marcocancarini/ExpressCardtoNVME/out/EC2M2_34/jlcpcb/EC2M2_34_estimate.md

# EC2M2_34 — JLCPCB estimate

Board size: 34.1 x 70.1 mm, 2 layers, 1.0 mm thick.
Fitted by hand (DNP for JLC): J1, JP1

| LCSC | Part | Qty/board | Type | Stock | Cost for 5 boards | Cost for 10 boards |
|---|---|---|---|---|---|---|
| C45783 | CL21A226MAQNNNE (22uF) | 1 | basic | 3512273 | $1.73 | $2.69 |
| C1525 | CL05B104KO5NNNC (100nF) | 1 | basic | 36039359 | $0.06 | $0.06 |
| C2286 | KT-0603R (LED red) | 1 | basic | 7299726 | $0.15 | $0.15 |
| C5360192 | 9774010243R (M2 SMT nut H1.0) | 2 | extended | 883 | $5.85 | $11.70 |
| C52766481 | MLD-NGFF-M-3.2H (M.2 M-key H3.2) | 1 | extended | 258 | $2.23 | $3.52 |
| C25117 | 0402WGF4700TCE (470) | 1 | basic | 1114424 | $0.03 | $0.03 |

| Components total | 5 boards: $10.05 | 10 boards: $18.16 |
|---|---|---|

Extended parts: 2 (JLC charges a setup fee for each extended part, typically $3 each).
Not included: PCB, assembly setup, stencil, shipping: the quote on the website computes them.
