marcocancarini/ExpressCardtoNVME/out/EC2M2_34_USB5V/jlcpcb/EC2M2_34_USB5V_estimate.md

# EC2M2_34_USB5V — JLCPCB estimate

Board size: 34.1 x 70.1 mm, 2 layers, 1.0 mm thick.
Fitted by hand (DNP for JLC): J1, J3, J4, JP1

| LCSC | Part | Qty/board | Type | Stock | Cost for 5 boards | Cost for 10 boards |
|---|---|---|---|---|---|---|
| C45783 | CL21A226MAQNNNE (22uF) | 1 | basic | 3512376 | $1.73 | $2.69 |
| C1525 | CL05B104KO5NNNC (100nF) | 1 | basic | 36039235 | $0.06 | $0.06 |
| C19702 | CL10A106KP8NNNC (10uF) | 2 | basic | 11884151 | $0.42 | $0.64 |
| C2286 | KT-0603R (LED red) | 1 | basic | 7297232 | $0.15 | $0.15 |
| C5360192 | 9774010243R (M2 SMT nut H1.0) | 2 | extended | 883 | $5.85 | $11.70 |
| C52766481 | MLD-NGFF-M-3.2H (M.2 M-key H3.2) | 1 | extended | 258 | $2.23 | $3.52 |
| C76793 | MLP2016S1R0MT0S1 (1uH) | 1 | extended | 2077 | $0.78 | $1.22 |
| C25117 | 0402WGF4700TCE (470) | 1 | basic | 1114404 | $0.03 | $0.03 |
| C59567 | TPS61240DRVR (TPS61240DRV) | 1 | extended | 2994 | $5.52 | $9.13 |

| Components total | 5 boards: $16.78 | 10 boards: $29.14 |
|---|---|---|

Extended parts: 4 (JLC charges a setup fee for each extended part, typically $3 each).
Not included: PCB, assembly setup, stencil, shipping: the quote on the website computes them.
