marcocancarini/ExpressCardtoNVME/docs/img/EC2M2_34_3d.png

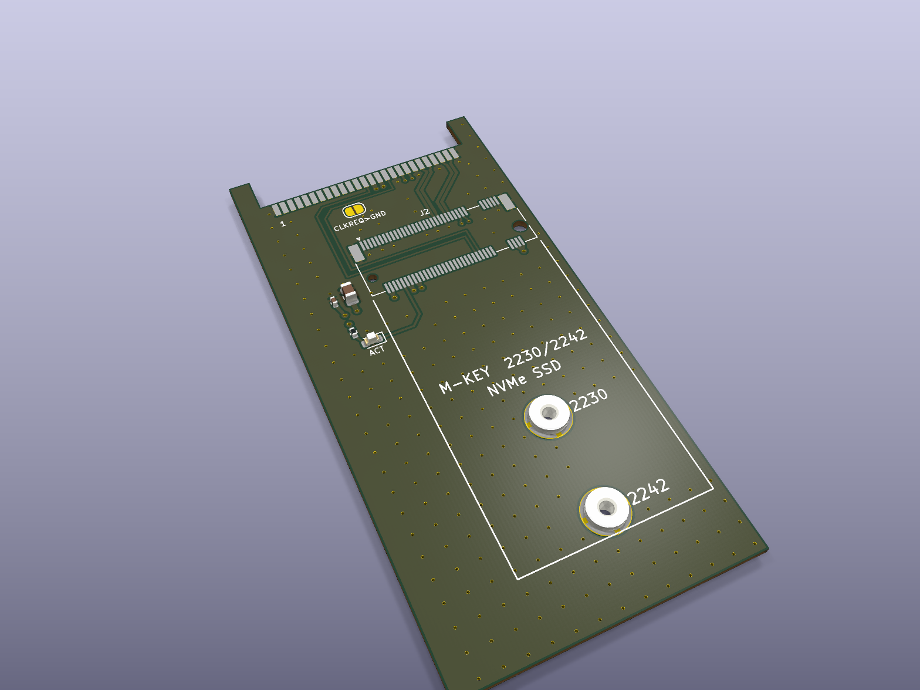
docs/img/EC2M2_34_3d.png
