marcocancarini/ExpressCardtoNVME/docs/img/EC2M2_34_bottom.png

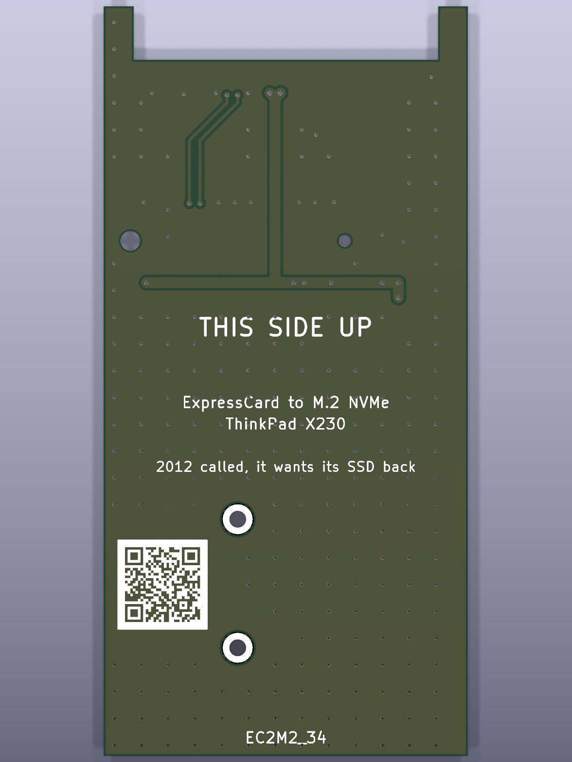
docs/img/EC2M2_34_bottom.png
