marcocancarini/ExpressCardtoNVME/docs/img/EC2M2_34_USB5V_3d.png

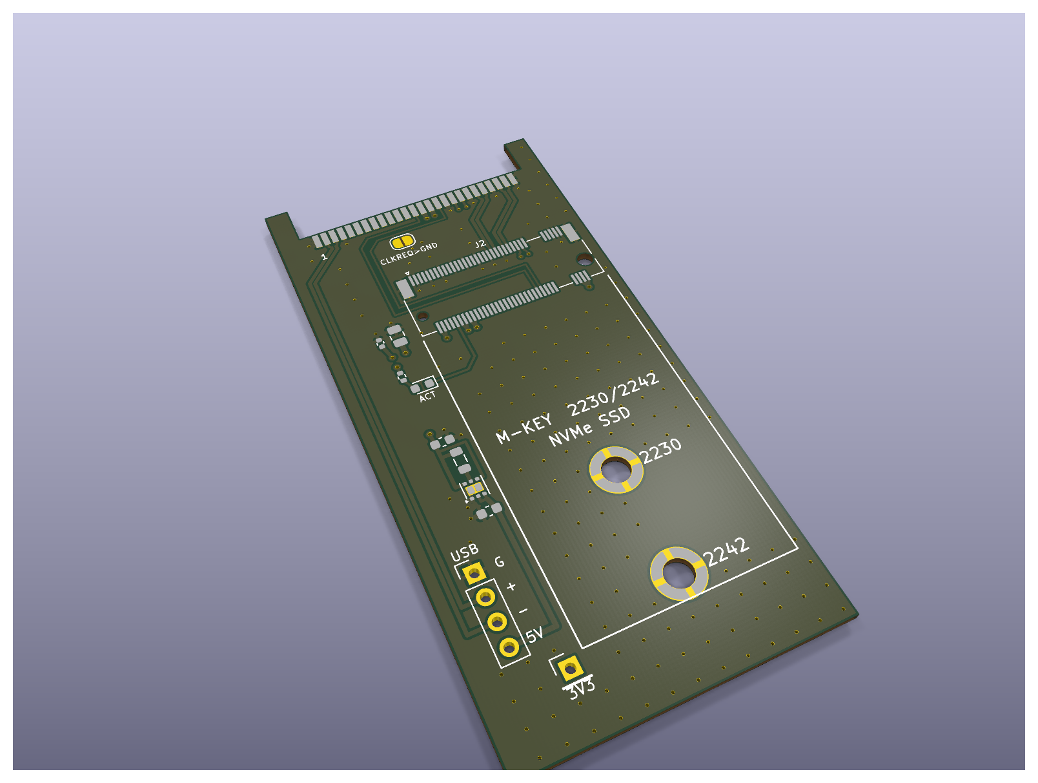
docs/img/EC2M2_34_USB5V_3d.png
