marcocancarini/ExpressCardtoNVME/docs/img/EC2M2_54_3d.png

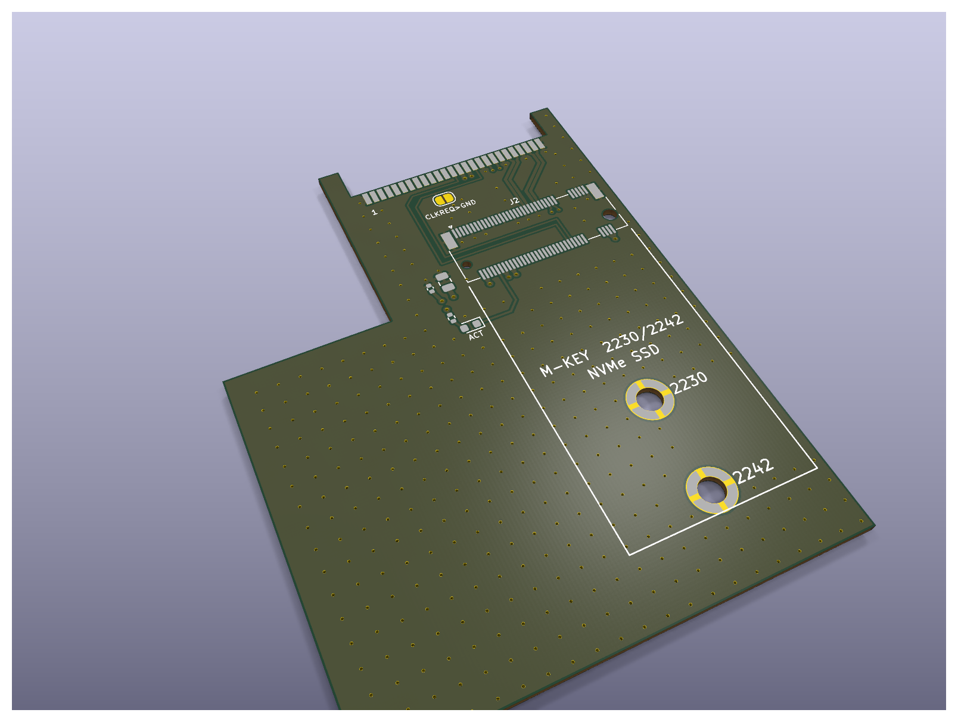
docs/img/EC2M2_54_3d.png
