marcocancarini/ExpressCardtoNVME/docs/img/EC2M2_54_bottom.png

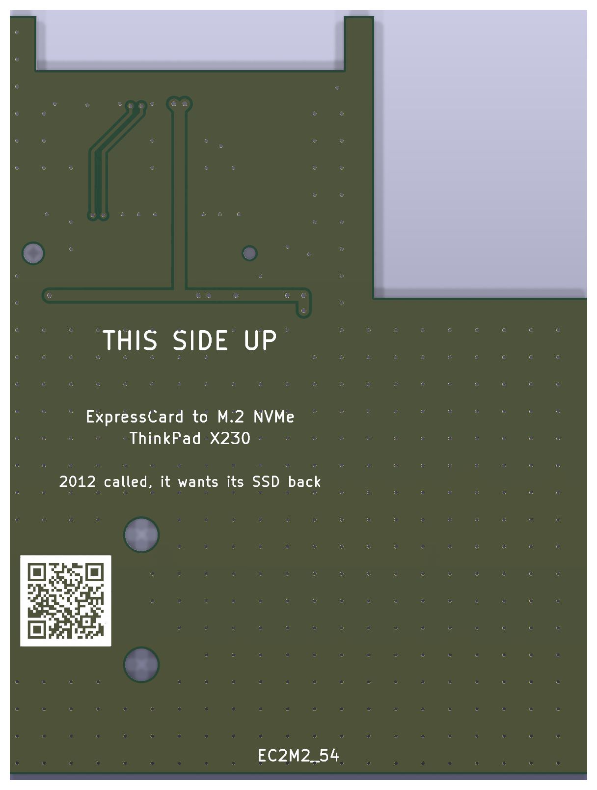
docs/img/EC2M2_54_bottom.png
