marcocancarini/ExpressCardtoNVME/docs/img/EC2M2_54_USB5V_bottom.png

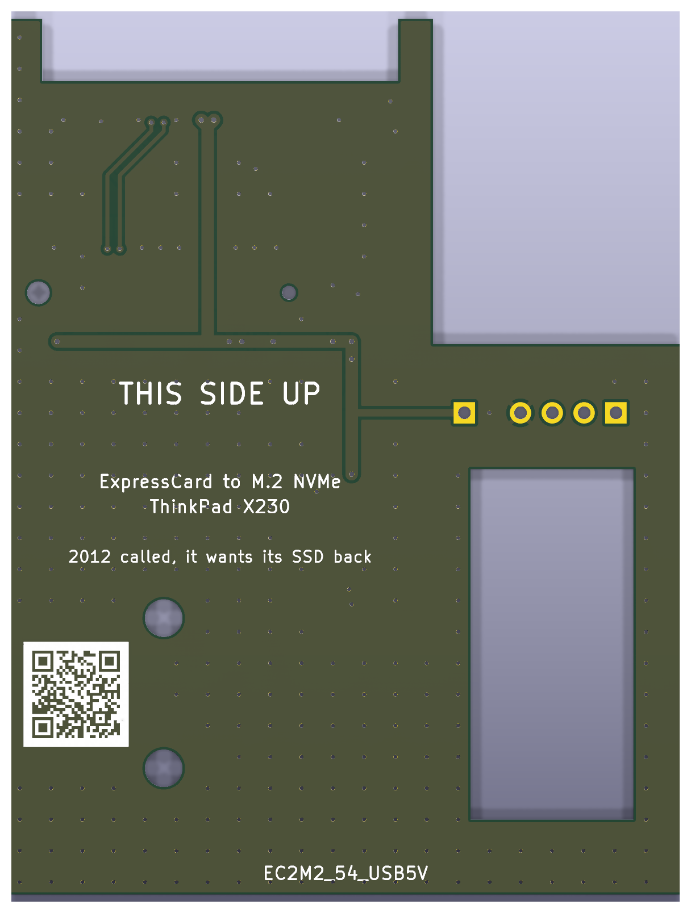
docs/img/EC2M2_54_USB5V_bottom.png
