marcocancarini/ExpressCardtoNVME/out/EC2M2_34/fab/EC2M2_34_top.png

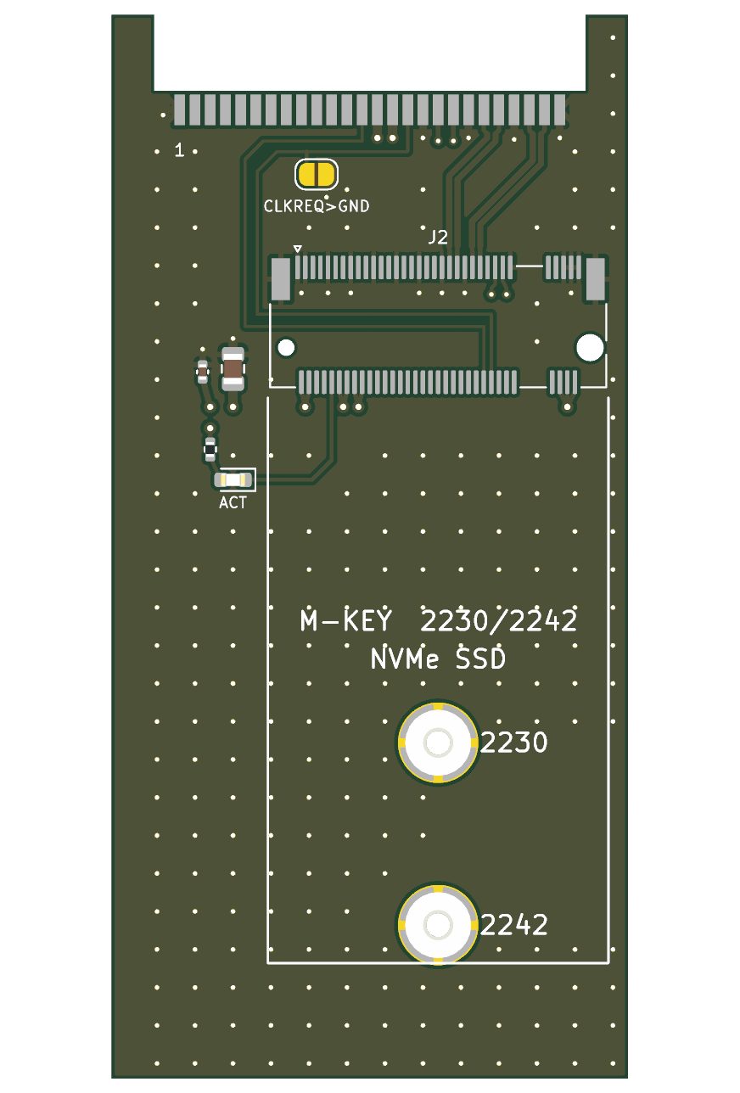
out/EC2M2_34/fab/EC2M2_34_top.png
