marcocancarini/ExpressCardtoNVME/out/EC2M2_34_USB5V/fab/EC2M2_34_USB5V_bottom.png

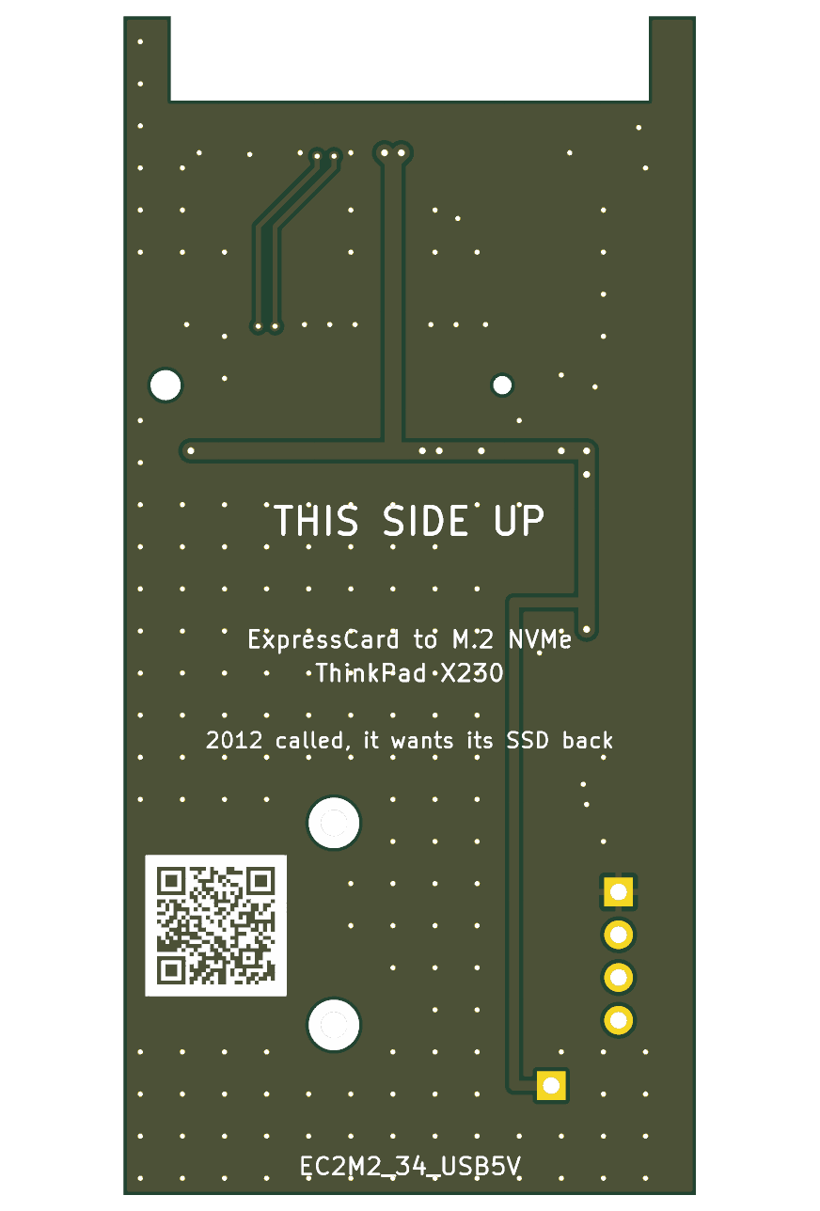
out/EC2M2_34_USB5V/fab/EC2M2_34_USB5V_bottom.png
