marcocancarini/ExpressCardtoNVME/out/EC2M2_34_USB5V/fab/EC2M2_34_USB5V_top.png

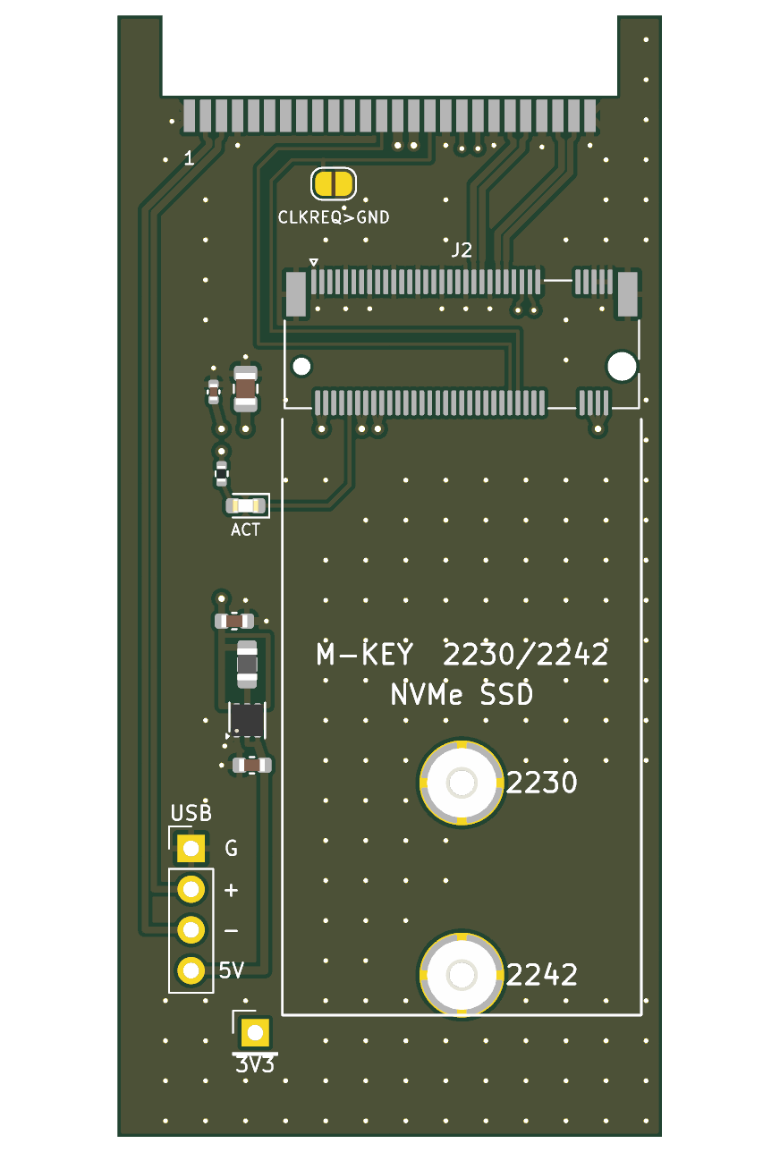
out/EC2M2_34_USB5V/fab/EC2M2_34_USB5V_top.png
