marcocancarini/ExpressCardtoNVME/out/EC2M2_54/fab/EC2M2_54_bottom.png

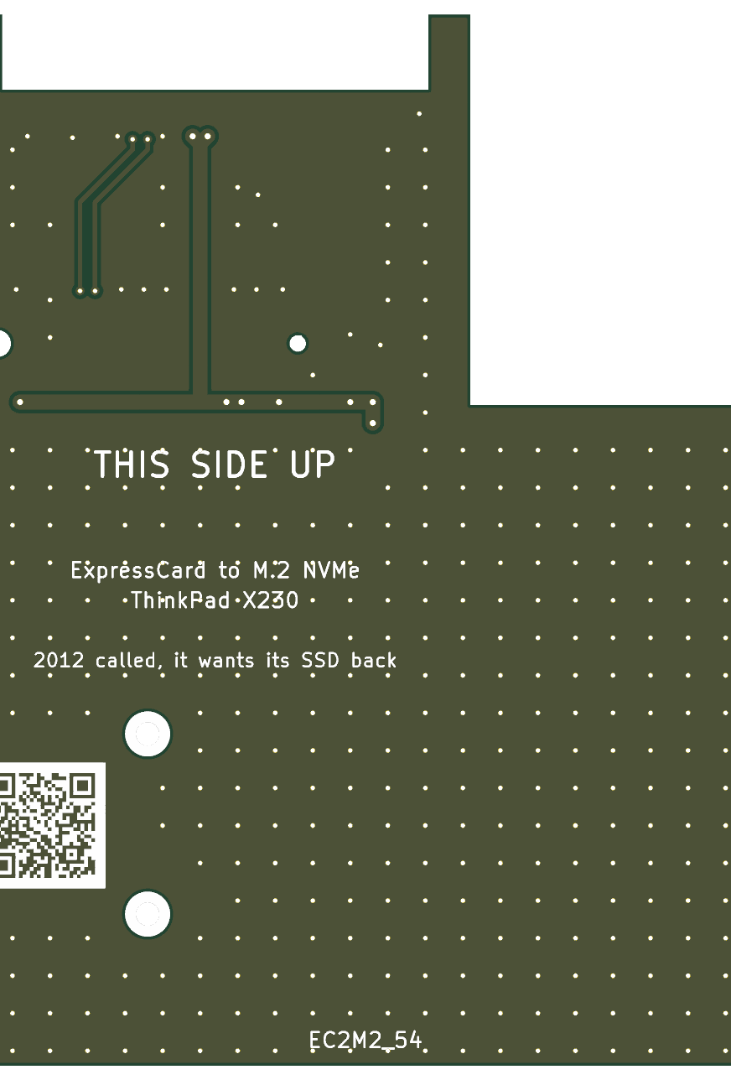
out/EC2M2_54/fab/EC2M2_54_bottom.png
