marcocancarini/ExpressCardtoNVME/out/EC2M2_54/fab/EC2M2_54_top.png

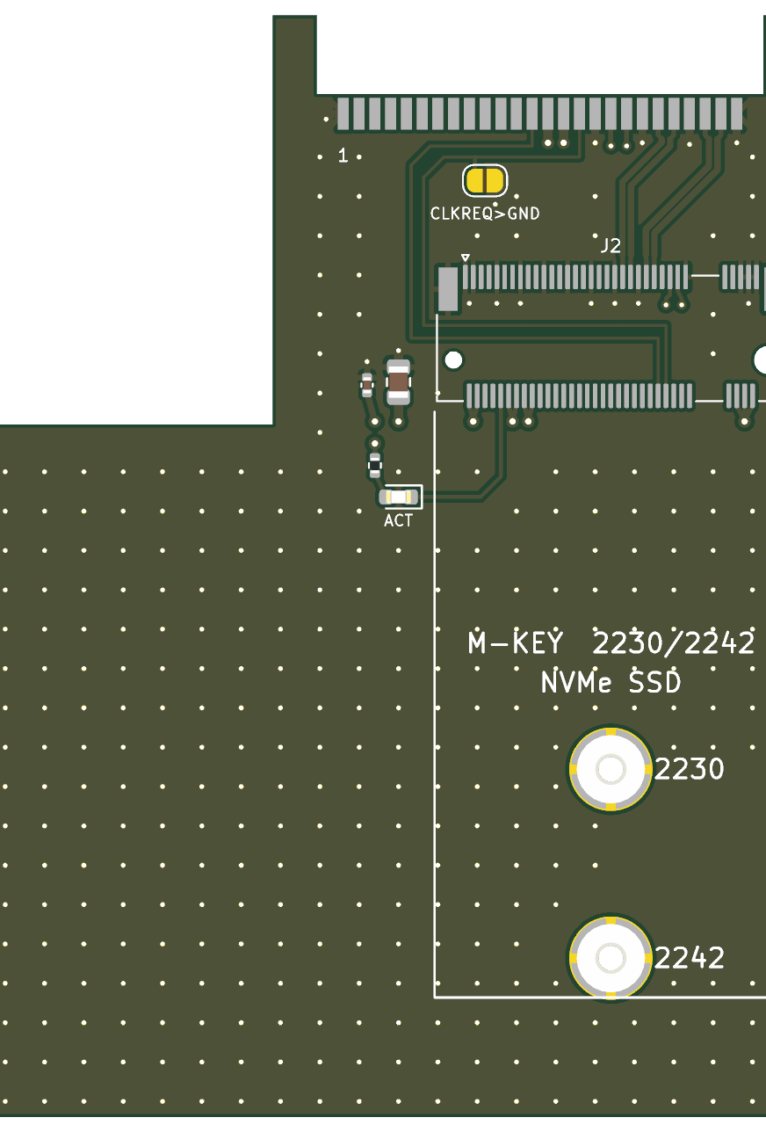
out/EC2M2_54/fab/EC2M2_54_top.png
