marcocancarini/ExpressCardtoNVME/out/EC2M2_34/EC2M2_34_BOM.csv

Comment | Designator | Footprint | LCSC | Note
22uF | C1 | C_0805_2012Metric | C45783 | 22uF 25V X5R 0805
100nF | C2 | C_0402_1005Metric | C1525 | 100nF 0402
LED red | D1 | LED_0603_1608Metric | C2286 | LED red 0603 (Vf~2V)
M2 SMT nut H1.0 | H1 | Mounting_Wuerth_WA-SMSI-M2_H1mm_9774010243 | C5360192 | Wurth 9774010243R M2 SMT nut H1.0 (alt. Sinhoo SMTSO2010CTJ C2916319, verify land)
M2 SMT nut H1.0 | H2 | Mounting_Wuerth_WA-SMSI-M2_H1mm_9774010243 | C5360192 | Wurth 9774010243R M2 SMT nut H1.0 (alt. Sinhoo SMTSO2010CTJ C2916319, verify land)
ExpressCard 26P | J1 | ExpressCard_Module_1x26_P1.0mm |  | ExpressCard 26P module side SMT, 1.0 pitch (e.g. Amphenol 10030570-2113LF, JAE PX10) - VERIFY footprint
M.2 M-key H3.2 | J2 | TE_M.2_M_2x38-1MP_P0.5mm | C52766481 | M.2 M-key H3.2 Minlenda MLD-NGFF-M-3.2H (land pattern = TE 2199230)
CLKREQ-GND | JP1 | SolderJumper-2_P1.3mm_Open_RoundedPad1.0x1.5mm |  | solder jumper (open)
470 | R1 | R_0402_1005Metric | C25117 | 470R 0402
