marcocancarini/ExpressCardtoNVME/out/EC2M2_34/jlcpcb/EC2M2_34_BOM_JLC.csv

Comment | Designator | Footprint | LCSC Part #
22uF | C1 | C_0805_2012Metric | C45783
100nF | C2 | C_0402_1005Metric | C1525
LED red | D1 | LED_0603_1608Metric | C2286
M2 SMT nut H1.0 | H1,H2 | Mounting_Wuerth_WA-SMSI-M2_H1mm_9774010243 | C5360192
M.2 M-key H3.2 | J2 | TE_M.2_M_2x38-1MP_P0.5mm | C52766481
470 | R1 | R_0402_1005Metric | C25117
