marcocancarini/ExpressCardtoNVME/out/enclosure/EC2M2_34_case.stl

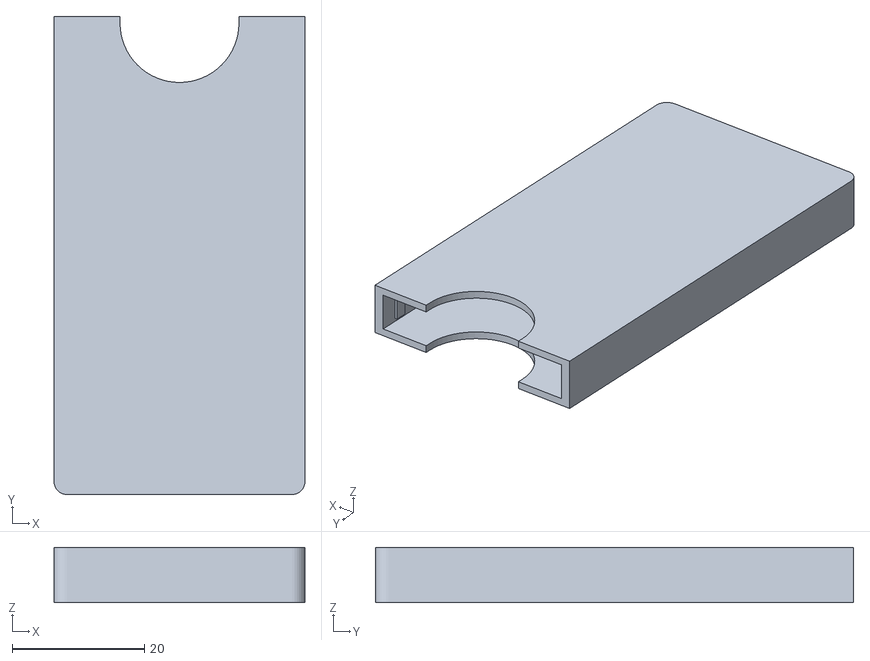
[picture p21: CAD file, 2026-10-29]
out/enclosure/EC2M2_34_case.stl
38.0 x 72.4 x 8.40
