marcocancarini/ExpressCardtoNVME/out/enclosure/EC2M2_54_case.stl

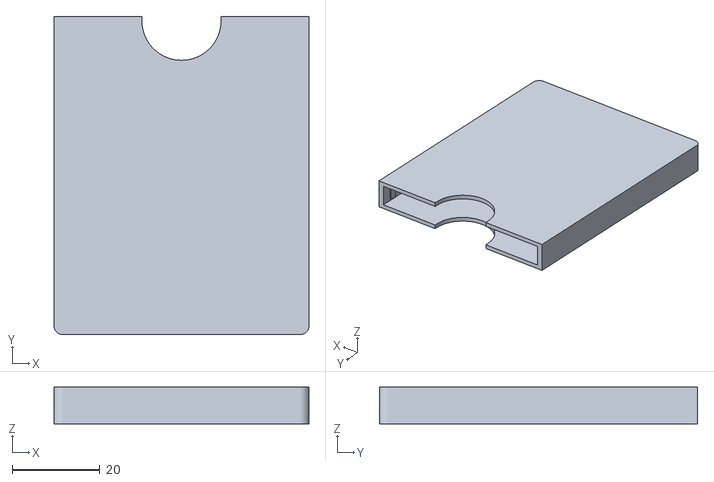
[picture p22: CAD file, 2026-10-29]
out/enclosure/EC2M2_54_case.stl
58.0 x 72.4 x 8.40
