marcocancarini/ExpressCardtoNVME/out/EC2M2_34/fab/EC2M2_34_print_1to1.pdf

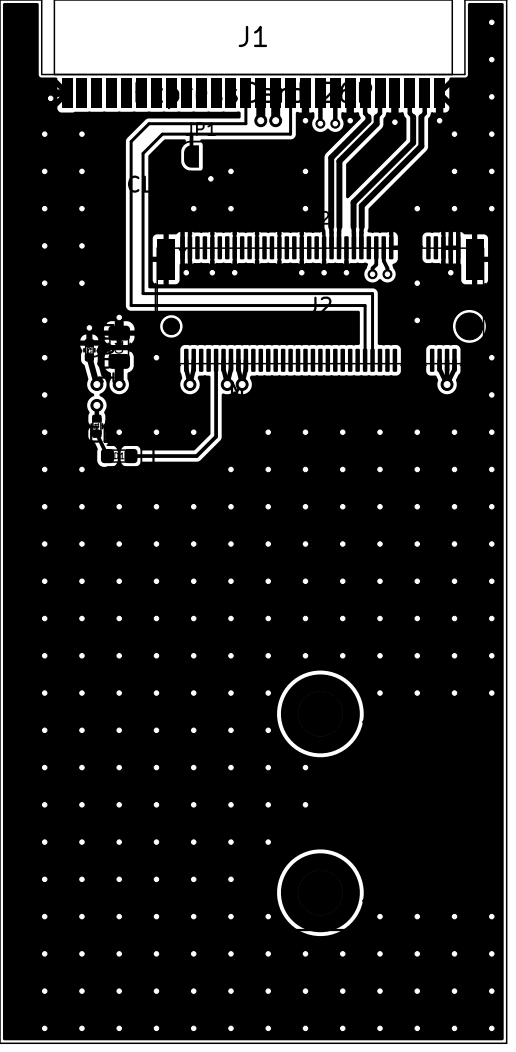
[picture p23: page 1]
