marcocancarini/ExpressCardtoNVME/out/EC2M2_34_USB5V/fab/EC2M2_34_USB5V_print_1to1.pdf

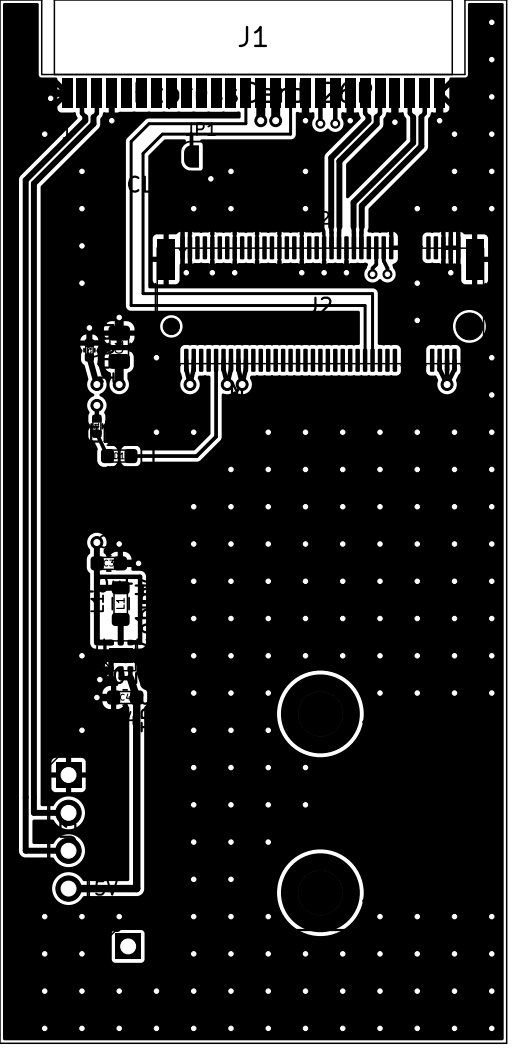
[picture p24: page 1]
