marcocancarini/ExpressCardtoNVME/out/EC2M2_54/fab/EC2M2_54_print_1to1.pdf

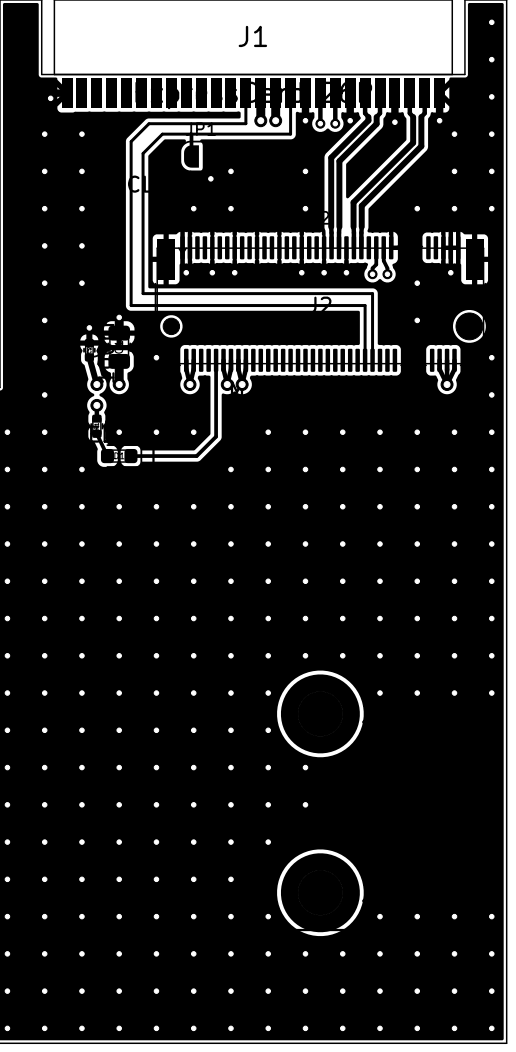
[picture p25: page 1]
