marcocancarini/ExpressCardtoNVME/out/EC2M2_54_USB5V/fab/EC2M2_54_USB5V_print_1to1.pdf

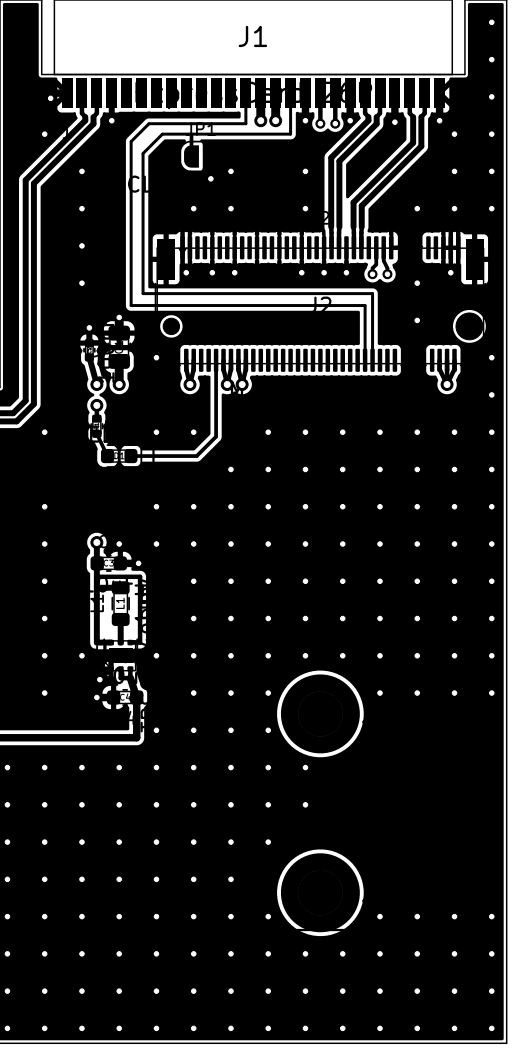
[picture p26: page 1]
