marcocancarini/ExpressCardtoNVME/out/EC2M2_34_USB5V/EC2M2_34_USB5V.kicad_pcb

## KiCad design out/EC2M2_34_USB5V/EC2M2_34_USB5V.kicad_pcb (2026-11-09)

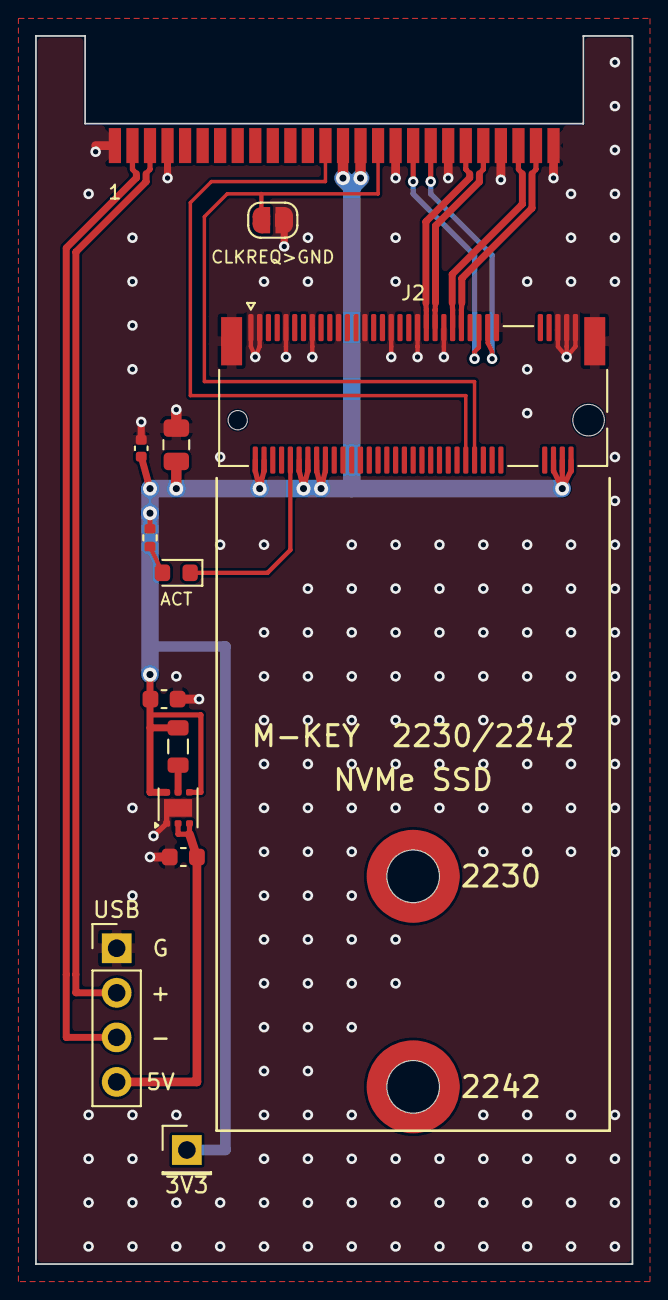
[picture p27: board EC2M2_34_USB5V.kicad_pcb from above]

Board: 2 copper layers, 34.0 x 70.0 mm, 15 parts (0 on the bottom side), 16 nets.

Parts:
C1: 22uF; C_0805_2012Metric
C2: 100nF; C_0402_1005Metric
C3, C4: 10uF; C_0603_1608Metric
D1: LED red; LED_0603_1608Metric
H1, H2: M2 SMT nut H1.0; Mounting_Wuerth_WA-SMSI-M2_H1mm_9774010243
J1: ExpressCard 26P; ExpressCard_Module_1x26_P1.0mm
J2: M.2 M-key H3.2; TE_M.2_M_2x38-1MP_P0.5mm
J3: USB pads; PinHeader_1x04_P2.54mm_Vertical
J4: 3V3 pad; PinHeader_1x01_P2.54mm_Vertical
JP1: CLKREQ-GND; SolderJumper-2_P1.3mm_Open_RoundedPad1.0x1.5mm
L1: 1uH; L_0805_2012Metric
R1: 470; R_0402_1005Metric
U1: TPS61240DRV; WSON-6-1EP_2x2mm_P0.65mm_EP1x1.6mm

Connections:
+3V3: C1.1, C2.1, C3.1, J1.14, J1.15, J2.2, J2.4, J2.12, J2.14, J2.16, J2.18, J2.70, J2.72, J2.74, J4.1, L1.2, R1.2, U1.4, U1.6
+5V: C4.1, J3.4, U1.2, U1.3
CLKREQ#: J1.16, J2.52, JP1.1
GND: C1.2, C2.2, C3.2, C4.2, J1.1, J1.4, J1.17, J1.20, J1.23, J1.26, J2.1, J2.3, J2.9, J2.15, J2.21, J2.27, J2.33, J2.39, J2.45, J2.57, J2.71, J2.73, J2.75, J2.MP, J3.1, JP1.2, U1.1, U1.7
LED#: D1.1, J2.10
LED_A: D1.2, R1.1
PERST#: J1.13, J2.50
PERn0: J1.21, J2.41
PERp0: J1.22, J2.43
PETn0: J1.24, J2.47
PETp0: J1.25, J2.49
REFCLK+: J1.19, J2.55
REFCLK-: J1.18, J2.53
SW: L1.1, U1.5
USB_D+: J1.3, J3.2
USB_D-: J1.2, J3.3
