marcocancarini/ExpressCardtoNVME/(commit log)

2026-10-29 Add PCB generator, 4 board variants, JLCPCB files, renders and docs
    - gen/: KiCad 10 Python generator for ExpressCard -> M.2 NVMe boards
    (34/54 mm, with/without 5V USB), DRC, netlist check, impedance solver,
    LCSC search, JLCPCB BOM/CPL export and render scripts
    - out/: generated KiCad projects, Gerbers, BOM/CPL, 1:1 print PDFs
    - docs/img: top/bottom/3D renders
    - README.md, GUIDA.md: overview, ordering, assembly and first boot guide
    [EC2M2_34-B_Cu.gbr, EC2M2_34-B_Mask.gbr, EC2M2_34-B_Silkscreen.gbr, EC2M2_34-Edge_Cuts.gbr, EC2M2_34-F_Cu.gbr, EC2M2_34-F_Mask.gbr, EC2M2_34-F_Paste.gbr, EC2M2_34-F_Silkscreen.gbr]
2026-10-29 Shorten boards to 70 mm and add separate 3.3V pad
    - Board length 75 -> 70 mm: flush with the ExpressCard slot (2242 SSD + nut end at ~62 mm)
    - Compact TPS61240 boost block under the SSD end
    - 34 mm USB: pads moved to a column next to the M.2 connector; 54 mm: shorter window
    - New J4 3V3 pad, kept apart from the 5V pad
    - check_nets.py: per-variant J3 pin order, checks 5V/GND/3V3 pads
    - Regenerated outputs, JLCPCB files, renders and docs
    [EC2M2_34-B_Cu.gbr, EC2M2_34-B_Mask.gbr, EC2M2_34-B_Silkscreen.gbr, EC2M2_34-Edge_Cuts.gbr, EC2M2_34-F_Cu.gbr, EC2M2_34-F_Mask.gbr, EC2M2_34-F_Paste.gbr, EC2M2_34-F_Silkscreen.gbr]
2026-10-29 Move USB power block to the free side strip and add 3D-printable case
    - TPS61240 boost (U1, L1, C3, C4) moved from the board end to the free strip
    left of the SSD, same relative layout rotated 90 degrees
    - 34 mm USB: label spacing fixed (no silkscreen overlaps)
    - gen/enclosure.py: parametric transport/storage case (STL + OpenSCAD) for
    34 and 54 mm boards; in-slot enclosure is not feasible (5.0 mm slot height)
    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
    [EC2M2_34-B_Cu.gbr, EC2M2_34-B_Mask.gbr, EC2M2_34-B_Silkscreen.gbr, EC2M2_34-Edge_Cuts.gbr, EC2M2_34-F_Cu.gbr, EC2M2_34-F_Mask.gbr, EC2M2_34-F_Paste.gbr, EC2M2_34-F_Silkscreen.gbr]
2026-10-29 Move USB power block to mid-board, beside the SSD area
    - TPS61240 boost block moved up to the middle of the left strip (y ~36-48),
    outside the SSD outline
    - 34 mm USB: J3 pads moved below the boost block, J4 3V3 pad fed on B.Cu
    along the left edge of the SSD area
    - 54 mm USB: shorter 5V route to the J3 pads
    - Regenerated outputs, JLCPCB files and renders
    [EC2M2_34-B_Cu.gbr, EC2M2_34-B_Mask.gbr, EC2M2_34-B_Silkscreen.gbr, EC2M2_34-Edge_Cuts.gbr, EC2M2_34-F_Cu.gbr, EC2M2_34-F_Mask.gbr, EC2M2_34-F_Paste.gbr, EC2M2_34-F_Silkscreen.gbr]
2026-10-29 Translate project to English, add CC BY-NC-SA 4.0 license and repo QR
    - Translate docs (GUIDA.md -> GUIDE.md), script comments and generated
    files (print_1to1.pdf, estimate.md) to English
    - Add LICENSE (CC BY-NC-SA 4.0, non-commercial)
    - Back silkscreen: drop the Italian line, add a small knockout QR code
    to the GitHub repo and a fun tagline
    - Regenerate boards, fab/JLCPCB files and renders (DRC clean)
    [EC2M2_34-B_Cu.gbr, EC2M2_34-B_Mask.gbr, EC2M2_34-B_Silkscreen.gbr, EC2M2_34-Edge_Cuts.gbr, EC2M2_34-F_Cu.gbr, EC2M2_34-F_Mask.gbr, EC2M2_34-F_Paste.gbr, EC2M2_34-F_Silkscreen.gbr]
2026-10-30 Document known issues and J1 connector sourcing in README
    - J1 (ExpressCard module connector): correct part family FCI/Amphenol
    10030570-21xxLF (e.g. 10030570-2112LF), TE equivalent, donor ExpressCard
    cards as cheap source; not on LCSC. Note that 'JAE PX10' in the BOM
    comment is not an ExpressCard connector.
    - Netclass diff-pair defaults (0.3/0.2) vs actual pairs (0.4/0.15): cosmetic.
    - Known design limits and verification status (DRC clean, check_nets OK,
    not yet manufactured/tested).
    Generated by Mistral Vibe.
2026-11-09 regenerate KiCad outputs (out/ gerber/fab/jlcpcb) and docs images for EC2M2_34/54 (+USB5V)
    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
    [EC2M2_34-B_Cu.gbr, EC2M2_34-B_Mask.gbr, EC2M2_34-B_Silkscreen.gbr, EC2M2_34-Edge_Cuts.gbr, EC2M2_34-F_Cu.gbr, EC2M2_34-F_Mask.gbr, EC2M2_34-F_Paste.gbr, EC2M2_34-F_Silkscreen.gbr]
